PHPirates/SolArduino/README.md

# [Link to website](https://phpirates.github.io/SolArduino/) 



Core 'best angle' calculations (Haskell):
