PHPirates/SolArduino/Documentation/src/documentation.tex

\documentclass{article}
\usepackage{hyperref} % used for links
\usepackage{listings}
\usepackage{circuitikz}
\usepackage{tikz}
\usepackage{xstring}
\usepackage{amsmath}
\usepackage{graphicx}
\usepackage{booktabs}

%--------------------Make usable space all of page
\setlength{\oddsidemargin}{0in}
\setlength{\evensidemargin}{0in}
\setlength{\topmargin}{0in}
\setlength{\headsep}{-.25in}
\setlength{\textwidth}{6.5in}
\setlength{\textheight}{8.5in}

\lstset{language=C, basicstyle=\ttfamily, breaklines=true}

% Hyperlink setup
\hypersetup{
colorlinks=true,
linkcolor=blue,
filecolor=magenta,
urlcolor=cyan,
}

% circuitikz shapes ---------------
%\makeatletter
% create the shape (switch without arrow) 
%\pgfcircdeclarebipole{}{\ctikzvalof{bipoles/interr/height 2}}{spst}{\ctikzvalof{bipoles/interr/height}}{\ctikzvalof{bipoles/interr/width}}{
%
%	\pgfsetlinewidth{\pgfkeysvalueof{/tikz/circuitikz/bipoles/thickness}\pgfstartlinewidth}
%
%	\pgfpathmoveto{\pgfpoint{\pgf@circ@res@left}{0pt}}
%	\pgfpathlineto{\pgfpoint{.6\pgf@circ@res@right}{\pgf@circ@res@up}}
%	\pgfusepath{draw}
%}

% make the shape accessible with nice syntax
% todo this breaks compilation
%\def\pgf@circ@spst@path#1{\pgf@circ@bipole@path{spst}{#1}}
%\tikzset{switch/.style = {\circuitikzbasekey, /tikz/to path=\pgf@circ@spst@path, l=#1}}
%\tikzset{spst/.style = {switch = #1}}
%\makeatother
% --------------------------------

% MATH -------------------------------------
% Vertical vector
\newcommand{\vvec}[1]{\begin{pmatrix}
                          #1
\end{pmatrix}}

\newcommand{\ipaddress}{http://192.168.8.42}

\begin{document}

    \tableofcontents
    \newpage

    \section{Maintenance}\label{sec:maintenance}
    \input{maintenance}

    \section{Setup of the project}\label{sec:setupOfTheProject}
    \input{../src/setup.tex}

    \section{Arduino Code}\label{sec:arduinoCode}
    \input{../src/arduinocode.tex}

    \section{Raspberry Pi API} \label{subsec:arduinotoandroid}
    \input{android.tex}

    \section{Calculations}\label{sec:calculations}
    \input{calculations}

    \section{Arduino}\label{ch:arduino}
    \input{arduino.tex}

\end{document}
