PHPirates/SolArduino/Desktop-app/src/SolArduino/resources/down.png

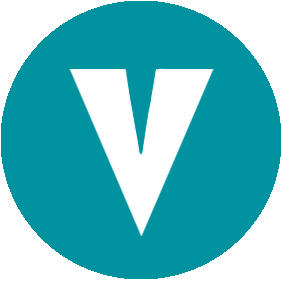
Desktop-app/src/SolArduino/resources/down.png
