PHPirates/SolArduino/Desktop-app/src/SolArduino/resources/up.png

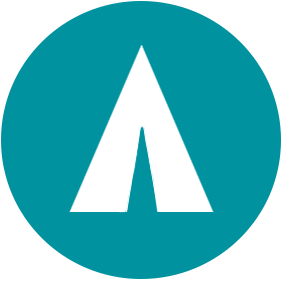
Desktop-app/src/SolArduino/resources/up.png
