PHPirates/SolArduino/Documentation/src/ArduinoCircuit.png

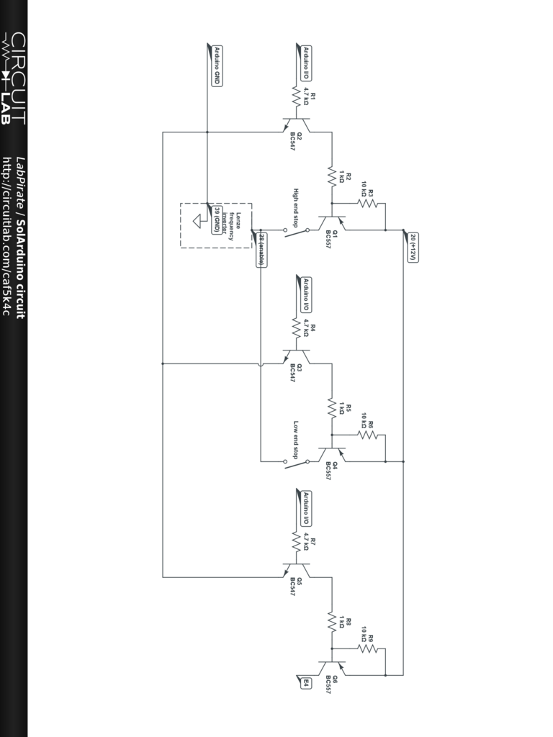
Documentation/src/ArduinoCircuit.png
