PHPirates/SolArduino/Documentation/src/graphs.JPG

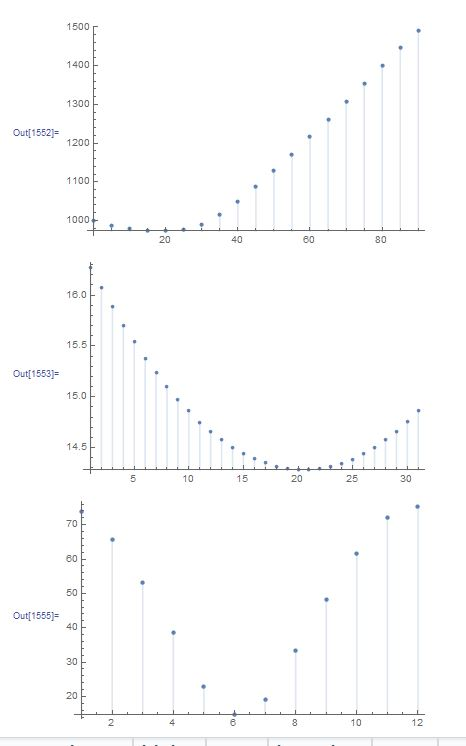
Documentation/src/graphs.JPG
