PHPirates/SolArduino/Photos/IMG_20190830_095444.jpg

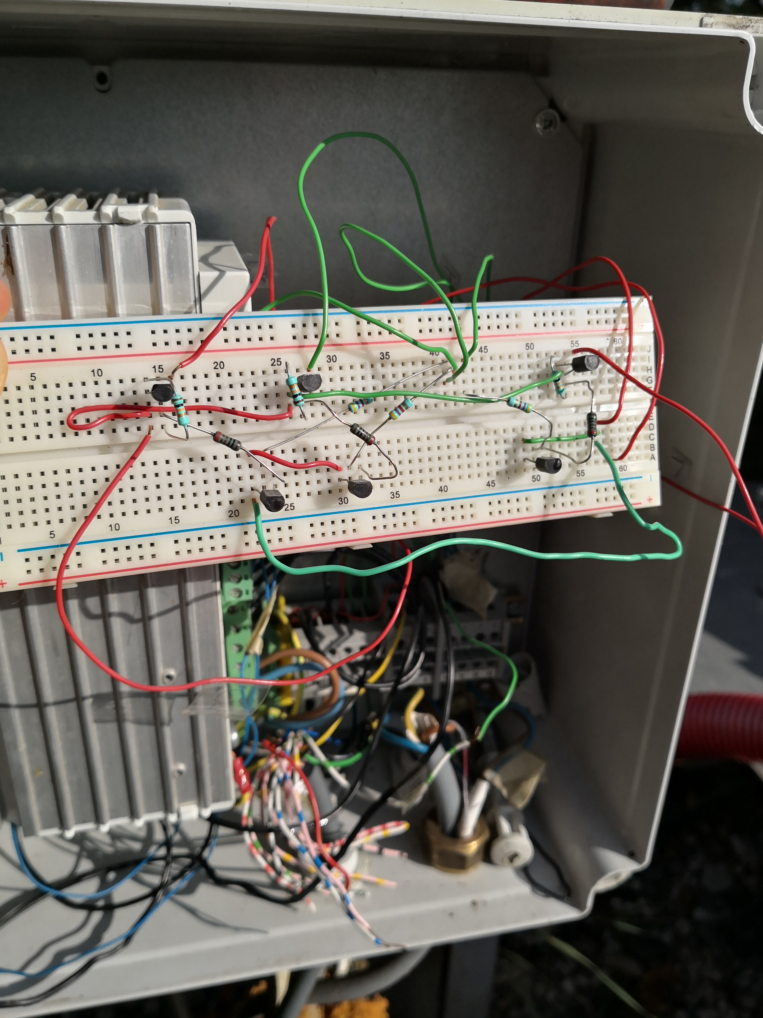
Photos/IMG_20190830_095444.jpg
