PHPirates/SolArduino/Photos/Screenshot_20190830_160738_com.abbyberkers.solarduino.jpg

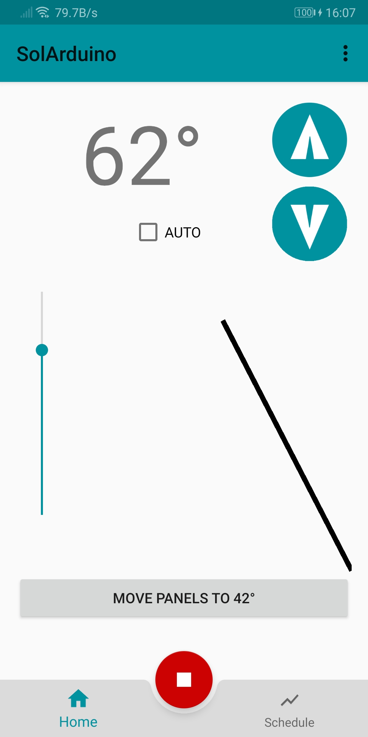
Photos/Screenshot_20190830_160738_com.abbyberkers.solarduino.jpg
