PHPirates/SolArduino/Photos/Screenshot_20190830_160756_com.abbyberkers.solarduino.jpg

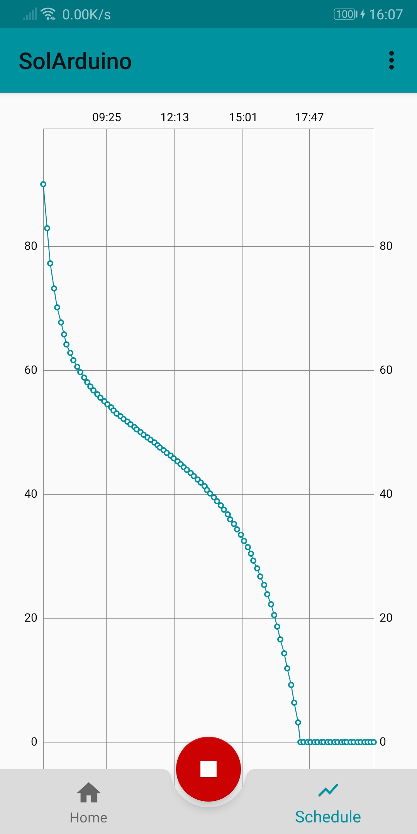
Photos/Screenshot_20190830_160756_com.abbyberkers.solarduino.jpg
