PHPirates/SolArduino/Documentation/src/maintenance.tex

\subsection{Changing IP address}\label{subsec:changingIpAddress}

The current ip address is \url{\ipaddress}.
Change it in the following places.
\begin{itemize}
    \item In the documentation,
    \item In the python on the Raspberry Pi,
    \item In the Android app,
    \item In the desktop app.
\end{itemize}

\subsection{Panels are stuck when out of bounds}\label{subsec:outOfBounds}

For safety, when panels go out of bounds they cannot move anymore in any direction.
To get them moving again, shortcut the low end stop if the panels are down, so shortcut terminal 10 and 11 like in Figure~\ref{lowendstop}.
Do the same for the high end stop on terminal 12 and 13 if the panels are up, like in Figure~\ref{highendstop}.

\begin{figure}
    \centering
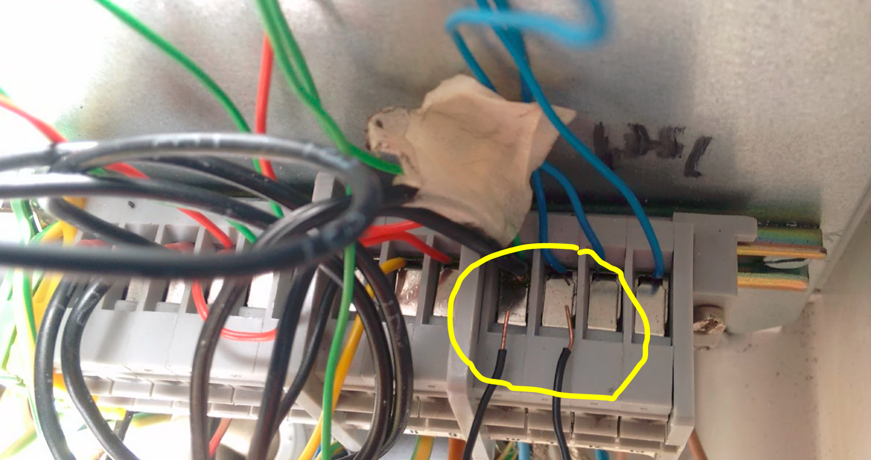
[picture p20: Documentation/src/images/lowendstop.PNG]
    
    \caption{Shortcutting the low end stop}
    \label{lowendstop}
\end{figure}
\begin{figure}
    \centering
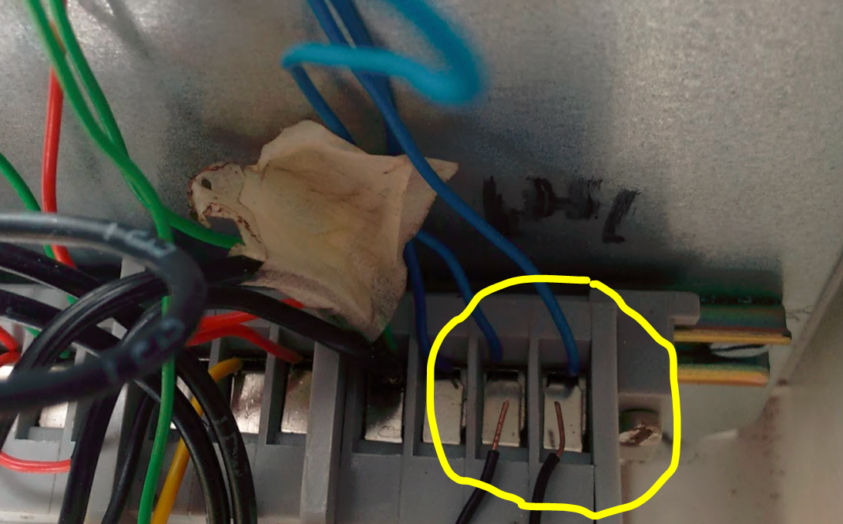
[picture p21: Documentation/src/images/highendstop.PNG]
    
    \caption{Shortcutting the high end stop}
    \label{highendstop}
\end{figure}
