PHPirates/SolArduino/(threads)

Thread 10 (2016-10-22):

Find out why pin 2 gives .7 volts as low voltage, and the rest .0

PHPirates, 2016-10-22:
and make sure this won't change sometime
see http://arduino.stackexchange.com/q/29745/23642

PHPirates, 2016-11-11:
let's hope it stays this way....

Closed 2016-11-11.

Thread 13 (2016-10-23):

Try to reuse ping function (maybe as menu option?)

PHPirates, 2016-10-23:

PHPirates, 2016-10-23:
https://bitbucket.org/slideclimb/solappduino/issues/75/app-when-buttons-are-hit-quick-after-each

Closed 2016-10-28.

Thread 27 (2016-10-31):

Is Arduino time still correct on winter time?

PHPirates, 2016-10-31:

PHPirates, 2017-03-29:
Hooray, it still works!

slideclimb, 2017-03-29:
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

Closed 2016-11-12.

Thread 45 (2016-12-19):

'Prove' that the code is correct, so it can run without hardware end stops

PHPirates, 2016-12-19:
- assumptions under which the arduino is safe
- the arduino is safe (under assumptions) because movement can only happen when ... (kind of assumption)

PHPirates, 2017-01-08:
Assumptions under which the code will work:
- [ ] potmeter is working. If it is not, the Arduino may try to move the panels through the end stops.
- [ ] circuit is working. If it is not, the panels may go up while the Arduino tries to stop them.
Proof:
in solarPanelUp/Down the code checks if the panels are not out of bounds. The panels are only moved using those methods. QED

Closed 2017-01-08.

Thread 48 (2016-12-30):

Add 'abort' button on Android/Desktop app for when panels are in auto mode

slideclimb, 2016-12-30:
- [ ] document 'emergencystate': the only place it is reset is on startup of arduino and panels will not move when in emergency
also, make a way to get the Arduino out of emergency state? make it a reset button which does both?
'abort' button for when the wifi doesn't work is another problem...

slideclimb, 2016-12-30:
- [ ] remember if panels were in auto mode
    - [ ] if auto mode: switch back to auto mode afterwards (at end time)
    - [ ] if not auto mode: set panels at angle it was before
        - [ ] remember angle
- [ ] remember begin and start time
- [ ] set panel to 0 at start time

Closed 2019-08-19.

Thread 52 (2017-01-03):

Take into account a disconnected potmeter wire (or other wires?)

PHPirates, 2017-01-03:

PHPirates, 2018-07-06:
Closed because of too low priority.

Closed 2018-07-06.

Thread 59 (2017-02-04):

Arduino can now respond with 'panels above upper bound!', needs to be processed

PHPirates, 2017-02-04:
"panels above upper bound!"
"panels below lower bound!"
Currently it tries to put it in place of the degrees

PHPirates, 2017-03-29:
fixed in 5b6c516576c6332471720cf43b301b8940e77bbf

Closed 2017-03-29.

Thread 107 (2019-09-01):

'move panels' button should move with screen height instead of fixed position

PHPirates, 2019-09-01:
