PHPirates/SolArduino/Documentation/circuit.pdf

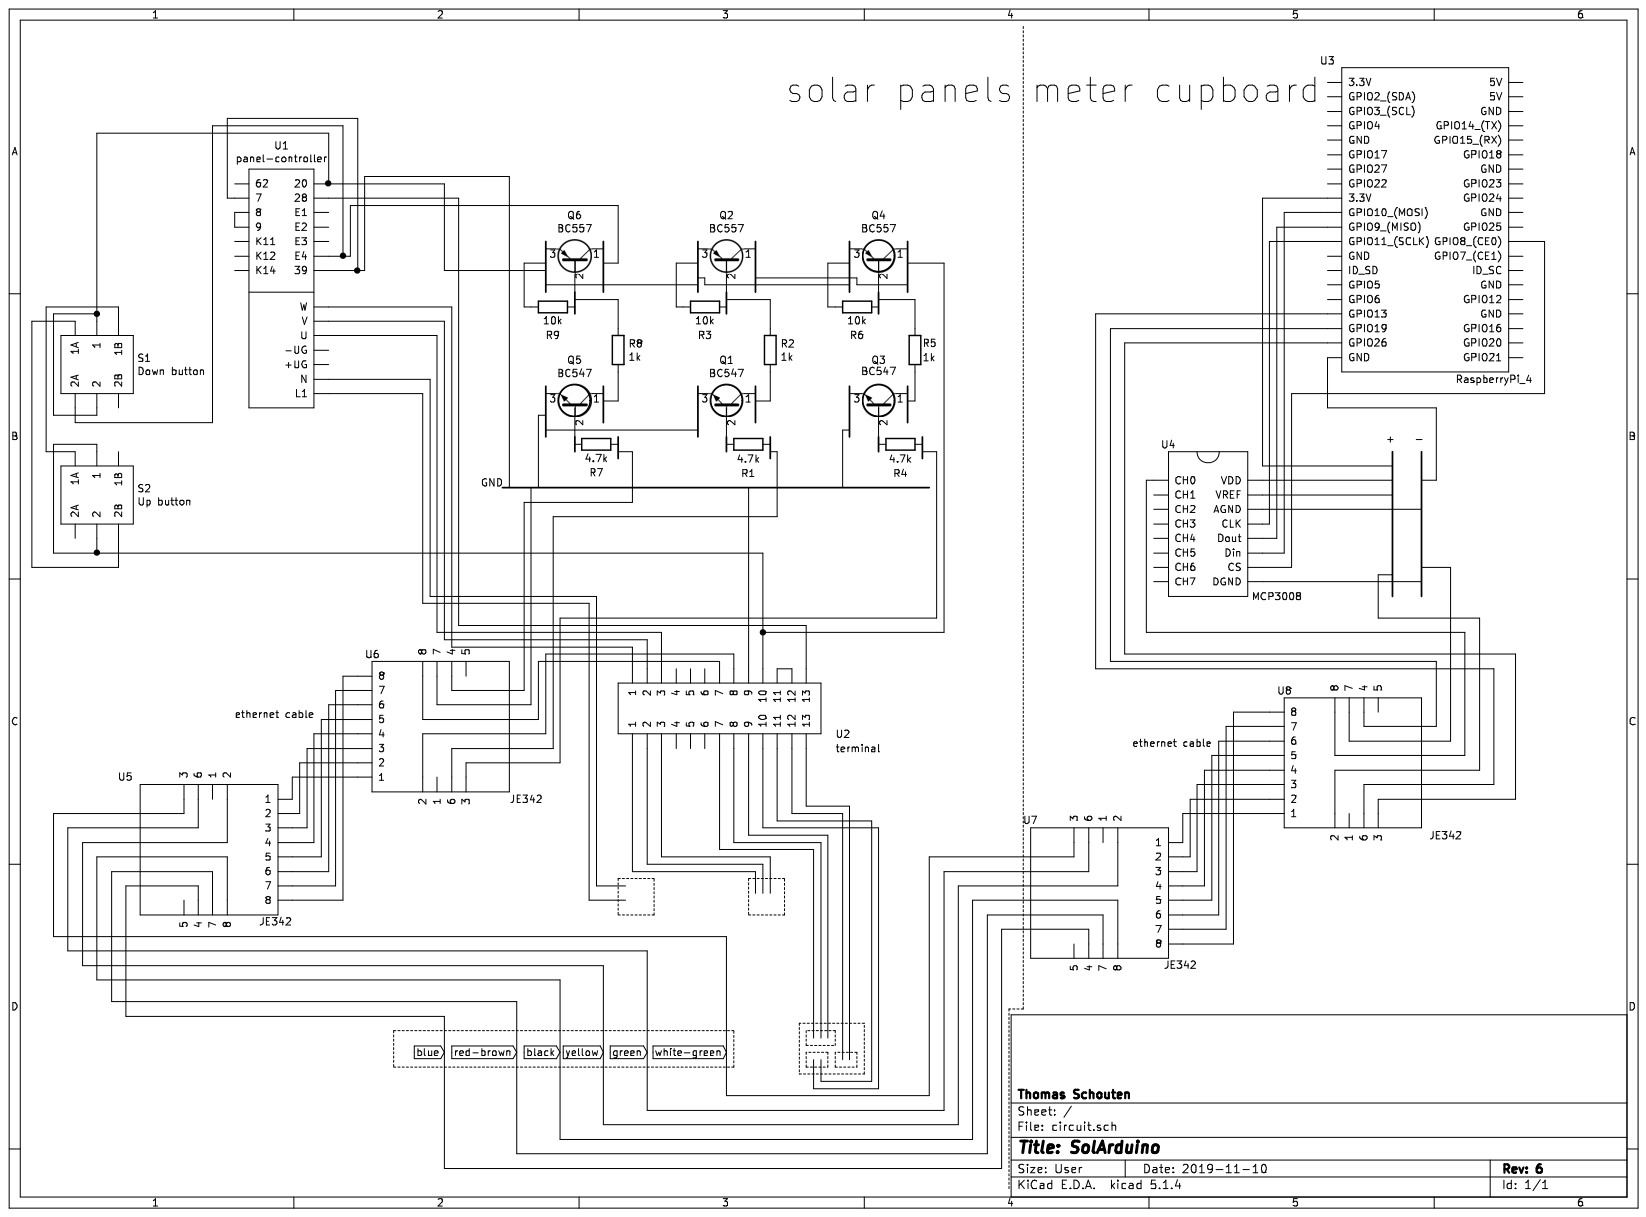
[picture p22: page 1]
