PHPirates/SolArduino/Documentation/circuit/circuit/circuit.kicad_pcb

## KiCad design mixer.sch

Schematic: mixer.sch

Parts:
J1: AudioJack3_Ground
RV1: 47k

Notes on the sheet:
NJM2505A
