PHPirates/SolArduino/Arduino/UnitTests/testSolarPanel/testSolarPanel.ino

//pin declarations
const byte POWER_HIGH = 3;
const byte DIRECTION_PIN = 4;
const byte POWER_LOW = 5;

void setup() {
  // put your setup code here, to run once:
  pinMode(POWER_HIGH,OUTPUT);
  pinMode(DIRECTION_PIN,OUTPUT);
  pinMode(POWER_LOW,OUTPUT);
  Serial.begin(9600);
}

void loop() {
  // put your main code here, to run repeatedly:
  solarPanelUp();
  delay(5000);
  solarPanelStop();
  delay(5000);
  solarPanelDown();
  delay(5000);
  solarPanelStop();
  delay(5000);
}

//solar panel movements
void solarPanelDown() {
  digitalWrite(POWER_LOW, HIGH); //Put current via the low end stop to 28
  digitalWrite(POWER_HIGH, LOW); //Make sure the high end circuit is not on
  digitalWrite(DIRECTION_PIN, HIGH); //To go down, also let the current flow to E4
}

void solarPanelUp() {
  digitalWrite(POWER_LOW, LOW);
  digitalWrite(POWER_HIGH, HIGH);
  digitalWrite(DIRECTION_PIN, LOW);
}

void solarPanelStop() {
  digitalWrite(POWER_LOW, LOW);
  digitalWrite(POWER_HIGH, LOW);
  digitalWrite(DIRECTION_PIN, LOW);
}
