PHPirates/SolArduino/(commit log)

2016-07-09 implemented ntp current time sync
2016-07-09 started wiring drawing
2016-07-12 added http response acknowledgement, fixes #8
    [SolArduino.ino]
2016-07-12 added http request x degrees, fixes #11
    [SolArduino.ino]
2016-07-16 [ard] fixed 0 on degrees < 10
    [SolArduino.ino]
2016-07-18 added power loss in calculations
2016-07-25 fixed #15 and added fancy arrow buttons
2016-07-26 fixed sunsetSeconds precision, given correct Jset
    [SolArduino.ino]
2016-07-30 added two mathematica power loss functions
2016-08-03 updated mathematica to expected arduino output
2016-08-03 fixed place of prints
    [SolArduino.ino]
2016-08-04 removed extra serial prints
2016-08-04 added debug prints
2016-08-04 fixed some radian issues
    [SolArduino.ino]
2016-08-04 fixed mistake in Mathematica calcs
    [SolArduino.ino]
2016-08-06 added power function, seperate notebook
2016-08-20 fixed #31 in powerfromthesun, fixed #30 in realPower.nb, fixed #33 in movingOverDay.nb, fixed #25 in powerfromthesun
2016-08-21 edited gitignore
    [data.csv, dataMay.csv]
2016-08-23 just committing latest version
    [data17_23.csv]
2016-08-25 merging files
    [data17_23.csv]
2016-08-26 fixed #49, added anglesPeriod
    [data19_25.csv, data2016.csv]
2016-08-28 fixed #44, also finished demonstration notebook
    [export.csv]
2016-08-30 re-added some files but still doesn't compile
    [SolArduino.ino]
2016-08-31 fixed #12, added Arduino circuit
2016-08-31 calibrated potmeter low end value and re-added time libraries
    [data24_30.csv, export.csv]
2016-08-31 fixes #47 import table with arduino, also fixed NTP code
    [SolArduino.ino]
2016-08-31 fixed #57, exports two csv files
    [angles.csv, times.csv]
2016-09-02 fixed something
    [angles.csv, times.csv]
2016-09-02 fixed degrees out of range
    [angles.csv, times.csv]
2016-09-04 fixed ntp needing a different dns
    [SolArduino.ino]
2016-09-06 finished parsing http request, still get a 400
    [angles.csv, times.csv]
2016-09-06 fixed #63 arduino unit tests
    [exampleWebClient.ino, exampleWebClientDHCP.ino, importTable.ino, ntpTest.ino]
2016-09-06 fixed ram problems, but dates are corrupt after parsing
    [SolArduino.ino]
2016-09-07 fixed #59, data from the nas, and a lot of other small bugs
    [SolArduino.ino]
2016-09-07 fixed #65, first handle request then call solarPanelAuto()
    [SolArduino.ino]
2016-09-08 fixed #50, gitignore test notebooks
    [SolArduino.ino]
2016-09-08 working on #62, changing floats to ints
    [angles.csv, times.csv]
2016-09-09 solaredge suddenly swapped month and day in the exports
    [data2_8.csv]
2016-09-10 changed floats to ints with three digits
    [angles.csv, times.csv]
2016-09-15 cleanup; trying to find out free space needed for nas request
    [angles.csv, times.csv]
2016-09-17 trying to log issue #75
    [SolArduino.ino]
2016-09-18 fixed #78 hopefully by increasing reading sample rate with a factor 100, and removed panelAuto() call when asking for update
    [SolArduino.ino]
2016-10-11 cherry-picked increase of sample rate
2016-10-23 re-fixed when panels are below 10 degrees, set angle button crashes
2016-10-23 fixed #18, http request on seperate thread
2016-10-27 fixed panels being put silently on auto in setup
    [SolArduino.ino]
2016-11-01 buttons resize! Yay!
2016-11-01 added exporting to demonstration.nb
    [angles.csv, times.csv]
2016-11-06 added button for today's graph
2016-11-10 reorganised arduino code
2016-11-11 fixed #9, message when nas out of angles
    [SolArduino.ino, communication.ino]
2016-11-12 fixed #27 winter time, for now...
    [SolArduino.ino, communication.ino, setup.ino]
2016-12-29 fixed #44, soft end stops + docs
    [SolArduino.ino]
2016-12-30 did #43 on arduino side, ready for testing
2017-01-03 fixed #43, one timer is enough
    [SolArduino.ino, communication.ino, solarPanelControl.ino]
2017-01-07 removed debug prints
2017-01-20 fixed #50, added next and previous day button
    [Main.java]
2017-02-02 desktop version with panels tested, automode broken
    [SolArduino.ino, solarPanelControl.ino]
2017-02-04 fixed 400 on nas request
    [SolArduino.ino, communicatin.ino, communication.ino, requestParseAngles.ino, setup.ino]
2017-02-04 updated app to include out of bounds Arduino message
2017-02-04 added 'check for updates' button
2017-02-28 should fix panels not going down on auto mode
    [SolArduino.ino]
2017-03-29 return auto state when out of bounds, fixes #60
    [communication.ino]
2017-06-27 hopefully fixed bug of panels not going up when below out of bounds
    [SolArduino.ino, solarPanelControl.ino]
2018-02-05 build using tectonic
    [angles.csv, data.csv, data17_23.csv, data19_25.csv, data2016.csv, data24_30.csv, data2_8.csv, dataMay.csv]
2018-04-15 added condition on potmeter high/low values, fixes #65, added unit test for movement with soft bounds
    [SolArduino.ino, testPotMeter.ino, testSolarPanel.ino, testSolarPanelWithBounds.ino]
2018-04-15 Update Arduino circuitry wire colours
2018-07-06 Relocate MMa and add initial haskell
    [angles.csv, data.csv, data17_23.csv, data19_25.csv, data2016.csv, data24_30.csv, data2_8.csv, dataMay.csv]
2018-07-14 Attempt at a power function
2018-07-16 Fix power function signature
2018-07-30 Add the real power function
2018-07-30 Add power tests
2018-08-01 Add total power function
2018-08-01 Add total power tests
2018-08-16 Add method to print angles to file
2019-08-02 Add test to control solar panels, fixes #74
    [test_panel_control.py]
2019-08-07 Rename folders
    [angles.csv, data.csv, data17_23.csv, data19_25.csv, data2016.csv, data24_30.csv, data2_8.csv, dataMay.csv]
2019-08-08 Fix paths in yml
    [panel_controller.py]
2019-08-10 Read potmeter, fixes #73
    [go_to_angle.py, panel_controller.py, solar_panel.py, solarduino.py, test_potmeter.py]
2019-08-12 up/down button
2019-08-14 Fix some auto mode bugs
    [auto_mode_thread.py, get_optimal_angles.py, go_to_angle.py]
2019-08-18 Fail to cancel timertask
    [panel_controller.py]
2019-08-18 Fix timer
2019-08-18 Make stop button send stop
2019-08-18 Stop button UI
2019-08-18 Not working daemon webserver
    [solarduino.py, test_daemon_webserver.py]
2019-08-22 Do not always try to stop all threads
2019-08-25 Start kicad circuit
    [circuit.kicad_pcb, circuit.sch]
2019-08-26 Update circuit
    [circuit.sch]
2019-08-27 Finish circuit v1
    [circuit.sch]
2019-08-28 add ethernet connectors
    [circuit.sch]
2019-08-28 Reset emergency, fixes #102
    [circuit.sch]
2019-08-28 Update docs
    [circuit.sch]
2019-08-28 Update parts list
    [circuit.sch]
2019-08-30 fix second ethernet box
    [circuit.sch]
2019-08-30 clean up a bit
    [circuit.sch]
2019-08-30 Stop movement timers properly
2019-09-01 Fix being able to reset emergency
    [solarduino.py]
2019-11-10 Remove incorrect junction
    [circuit.sch]
2020-03-12 Bump psutil from 5.6.3 to 5.6.6 in /Raspberry-Pi
    Bumps [psutil](https://github.com/giampaolo/psutil) from 5.6.3 to 5.6.6.
    - [Release notes](https://github.com/giampaolo/psutil/releases)
    - [Changelog](https://github.com/giampaolo/psutil/blob/master/HISTORY.rst)
    - [Commits](https://github.com/giampaolo/psutil/compare/release-5.6.3...release-5.6.6)
2022-01-29 Added hybrid revision
    [circuit.kicad_sch]
